relliky/Sunshine/product_documents/photos/sunshine/hardware_design.JPG

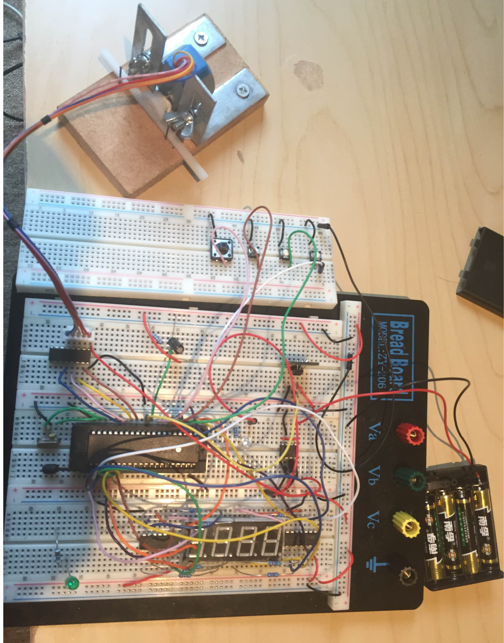
product_documents/photos/sunshine/hardware_design.JPG
