relliky/Sunshine/product_documents/photos/Physical_Design.JPG

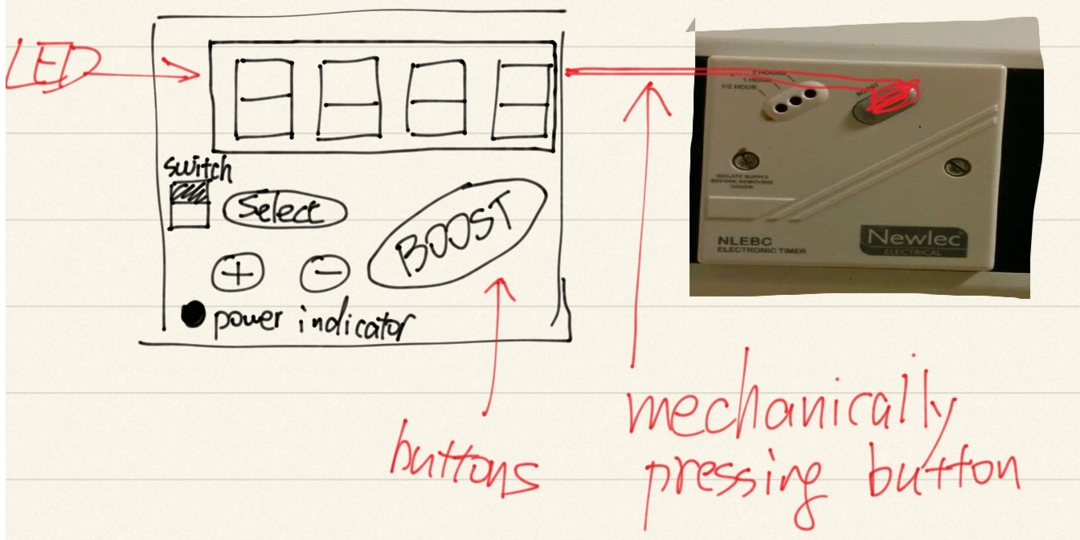
product_documents/photos/Physical_Design.JPG
