relliky/Sunshine/product_documents/Sunshine_Product_Requirement_Specification.docx

Product Requirement Specification

1. Customer Desired Requirement
i) Controlling room temperature in constant is ESSENTIAL
ii) Temperature can be set manually
iii) Low cost
iv) Low noise – Low frequency control
v) Battery can last long enough that customer can stand
2. Physical Requirment
i) Tightly attached to the timer pad
ii) Reasonable size
iii) Reasonable weight
iv) Users can see LED indicators originally on the timer pad
