relliky/Sunshine/engineering/design/hardware/hardware_system.docx

1. Button

OMRON ELECTRONIC COMPONENTS - B3F-1000 - SWITCH, SPNO, 0.05A, 24V, THT, 0.98N

http://onecall.farnell.com/omron-electronic-components/b3f-1000/switch-spno-0-05a-24v-tht-0-98n/dp/176432

Spec: see folder

2. Regulator

MAXIM INTEGRATED PRODUCTS - MAX603CPA+ - IC, V REG LDO ADJ/+5.0V, DIP8, 603

http://onecall.farnell.com/maxim-integrated-products/max603cpa/ic-v-reg-ldo-adj-5-0v-dip8-603/dp/1290858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

Spec: see folder

3. Darlington Transistor

STMICROELECTRONICS - ULN2003A - DARLINGTON ARRAY 7NPN, 2003, DIP16

http://onecall.farnell.com/stmicroelectronics/uln2003a/darlington-array-7npn-2003-dip16/dp/1094421

Spec: see folder

4. DS18B20 Thermometer

MAXIM INTEGRATED PRODUCTS - DS18B20+ - PROGRAMMABLE DIGITAL T'MOM, 12BIT

http://onecall.farnell.com/maxim-integrated-products/ds18b20/programmable-digital-t-mom-12bit/dp/SC10426

Spec: see folder

5. Jumper

MULTICOMP (FORMERLY FROM SPC) - SPC20479 - SHUNT JUMPER, 2POS, CODE STRIP LINE PLUG

http://onecall.farnell.com/multicomp-formerly-from-spc/spc20479/shunt-jumper-2pos-code-strip-line/dp/2396301

Spec: see folder

6. Crystal

TXC - 9B-11.0592MAAJ-B - XTAL, 11.0592MHZ, 18PF, HC-49S

http://onecall.farnell.com/txc/9b-11-0592maaj-b/xtal-11-0592mhz-18pf-hc-49s/dp/1842198

7. Battery Holder

PRO POWER - 23VB31B - BATTERY HOLDER, 3XAA SNAP

http://onecall.farnell.com/pro-power/23vb31b/battery-holder-3xaa-snap/dp/BT03710

Spec: see web
