relliky/Sunshine/misc/misc_photos/IMG_4469.JPG

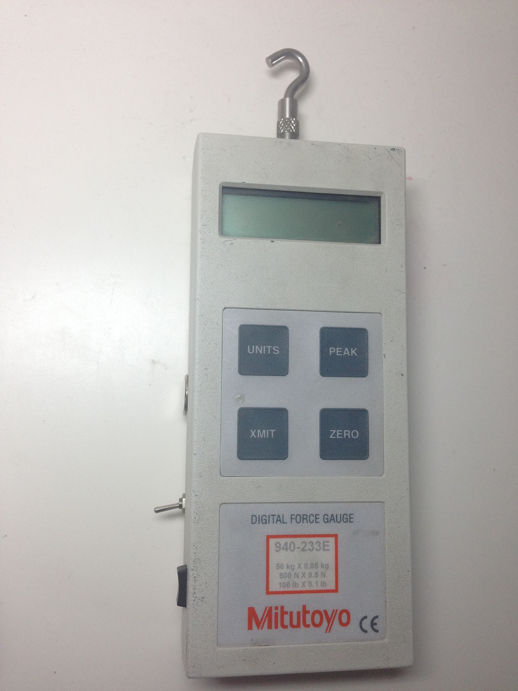
misc/misc_photos/IMG_4469.JPG
