relliky/Sunshine/misc/misc_photos/IMG_4470.JPG

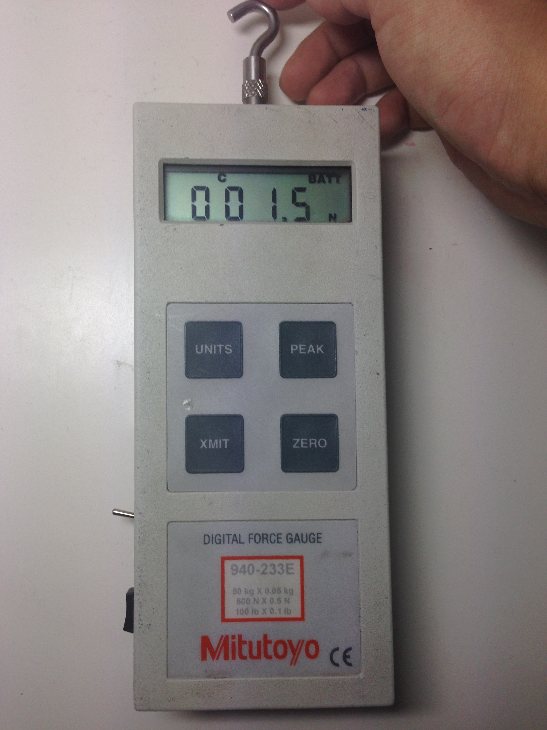
misc/misc_photos/IMG_4470.JPG
