relliky/Sunshine/misc/misc_photos/IMG_4477.JPG

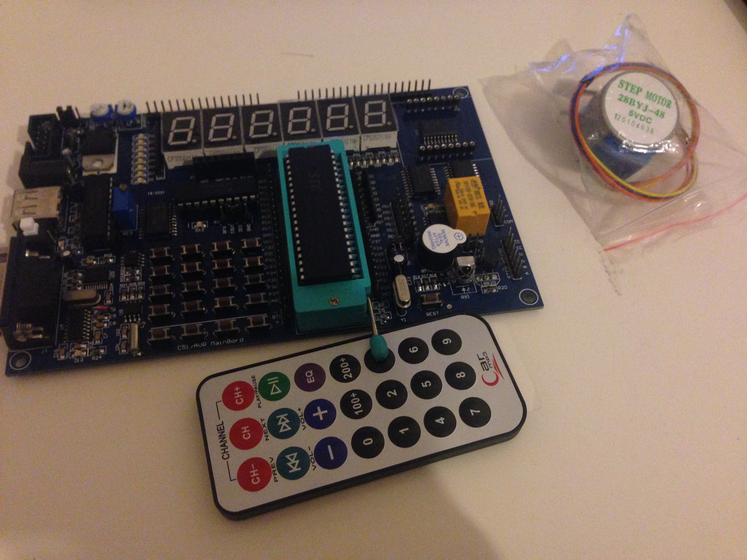
misc/misc_photos/IMG_4477.JPG
