relliky/Sunshine/misc/misc_photos/IMG_4478.JPG

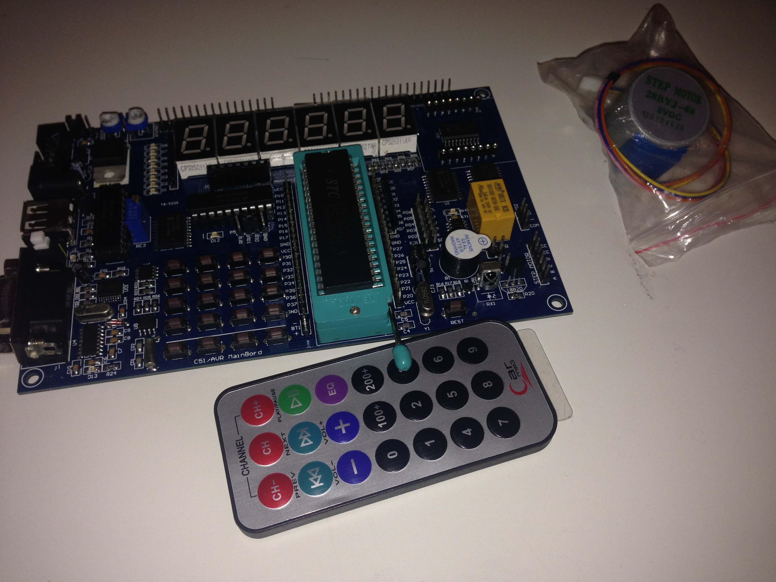
misc/misc_photos/IMG_4478.JPG
