relliky/Sunshine/misc/misc_photos/IMG_4536.JPG

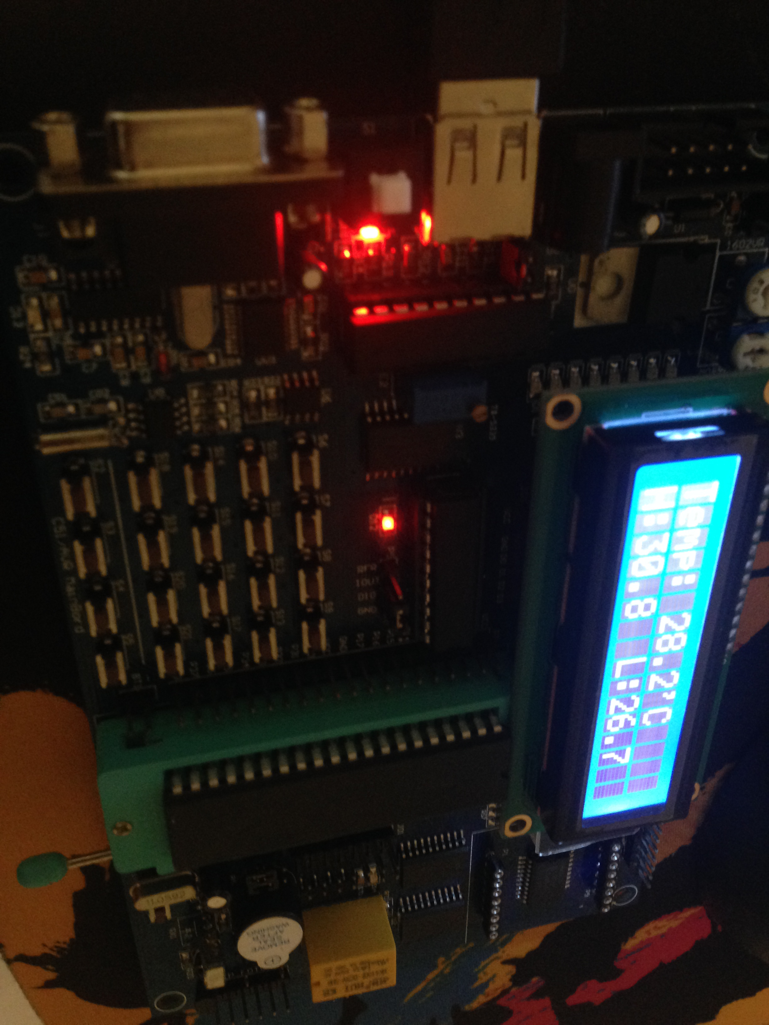
misc/misc_photos/IMG_4536.JPG
