relliky/Sunshine/misc/misc_photos/IMG_4537.JPG

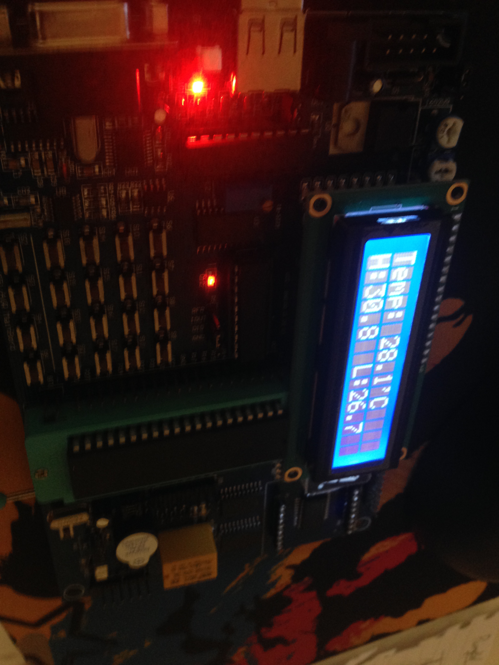
misc/misc_photos/IMG_4537.JPG
