relliky/Sunshine/misc/misc_photos/IMG_4538.JPG

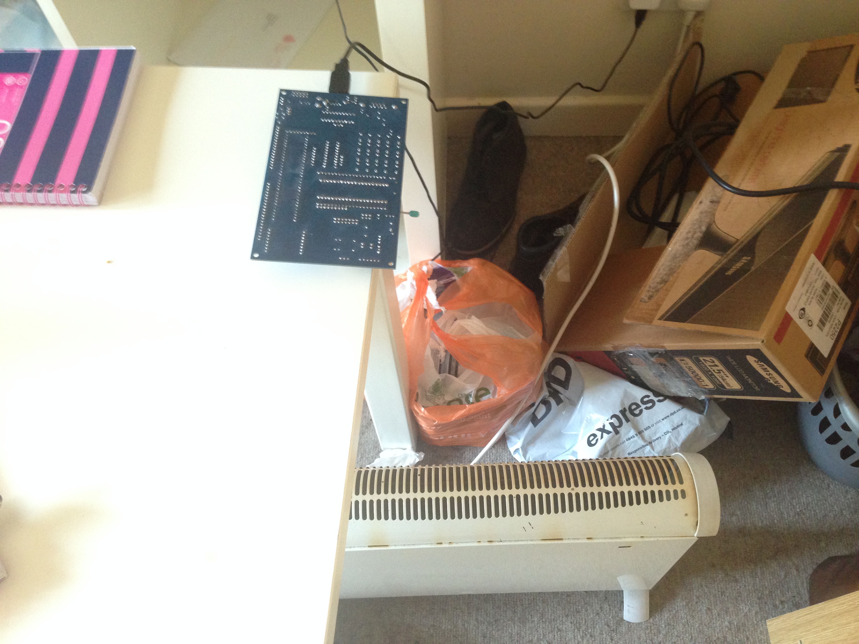
misc/misc_photos/IMG_4538.JPG
