relliky/Sunshine/misc/misc_photos/IMG_4539.JPG

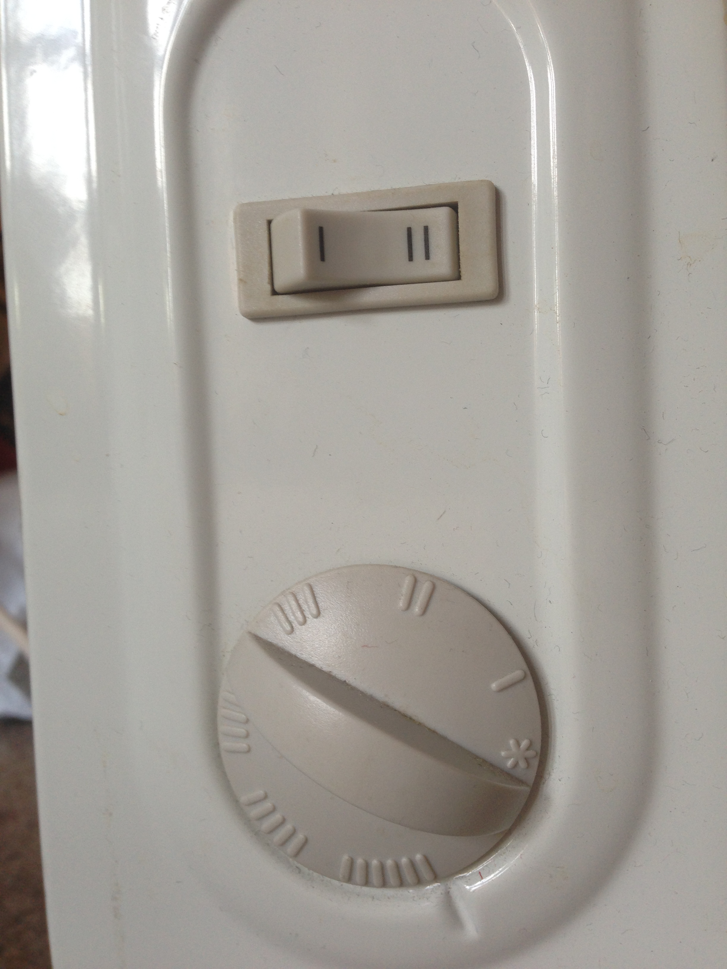
misc/misc_photos/IMG_4539.JPG
