relliky/Sunshine/misc/misc_photos/IMG_4540.JPG

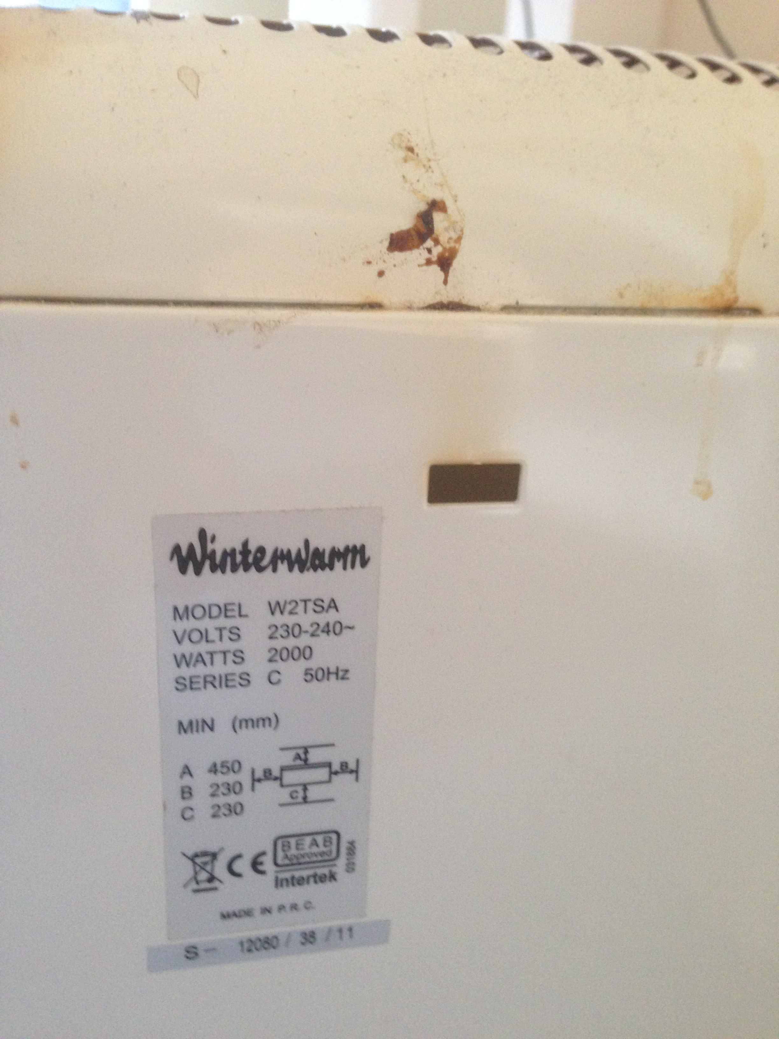
misc/misc_photos/IMG_4540.JPG
