relliky/Sunshine/misc/misc_photos/IMG_4542.JPG

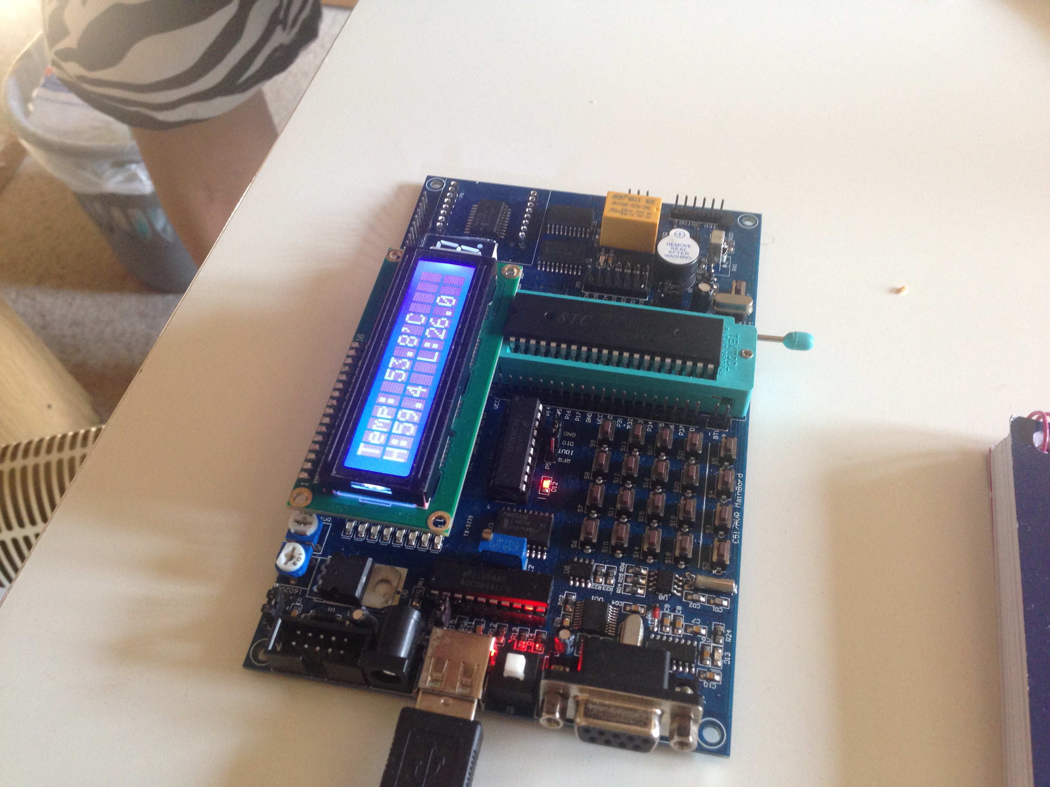
misc/misc_photos/IMG_4542.JPG
