relliky/Sunshine/product_documents/photos/exchange_works_timer.JPG

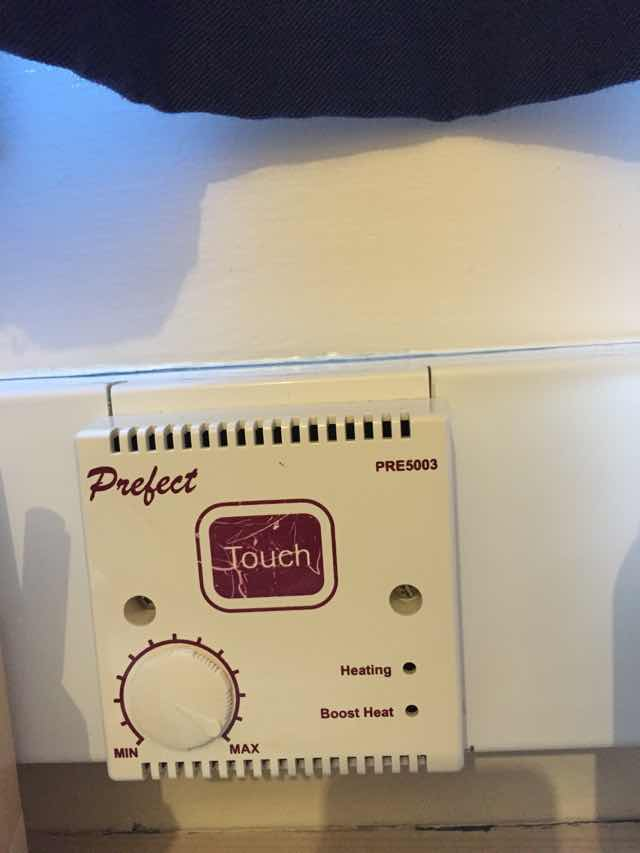
product_documents/photos/exchange_works_timer.JPG
