relliky/Sunshine/product_documents/photos/IMG_2048.JPG

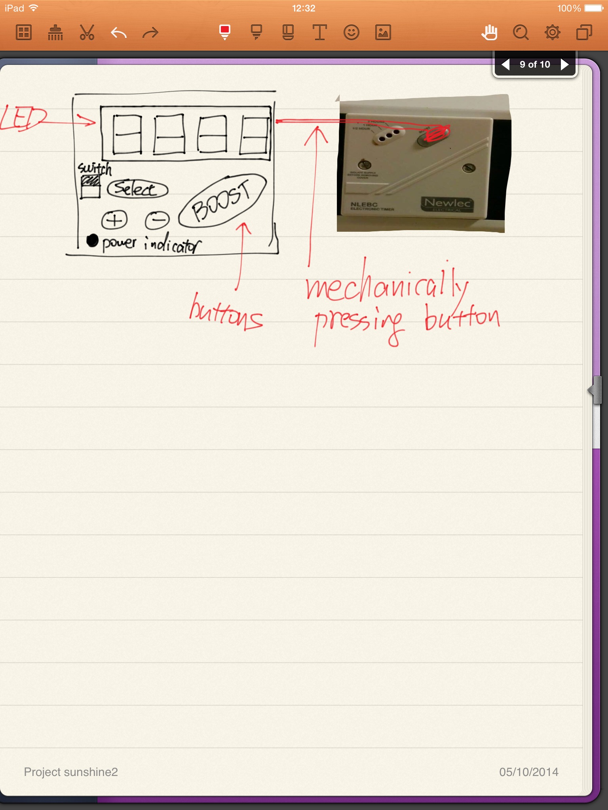
product_documents/photos/IMG_2048.JPG
