relliky/Sunshine/product_documents/photos/IMG_6342.JPG

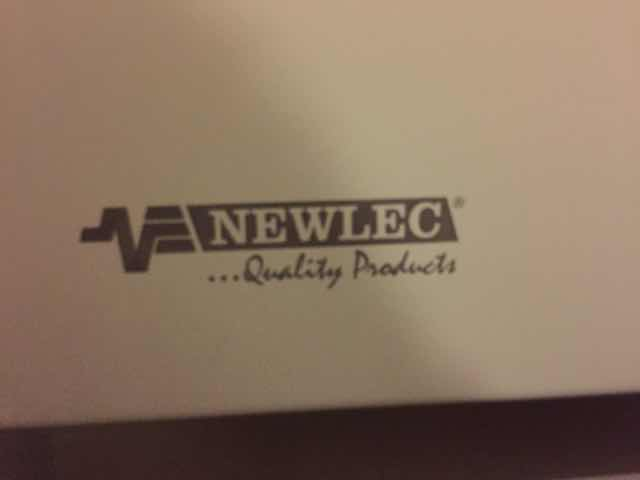
product_documents/photos/IMG_6342.JPG
