relliky/Sunshine/product_documents/photos/IMG_6343.JPG

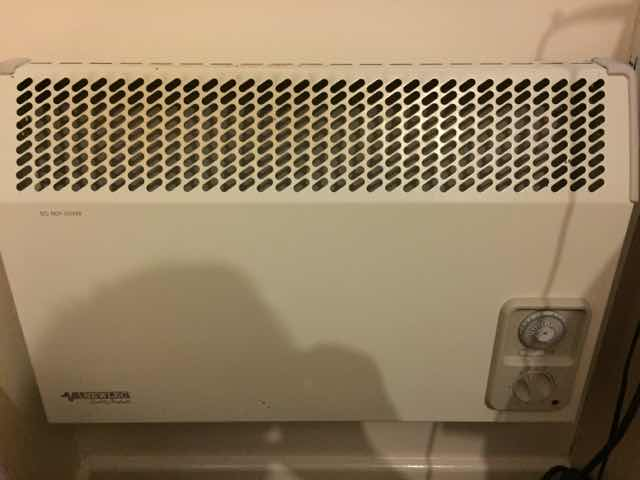
product_documents/photos/IMG_6343.JPG
