relliky/Sunshine/product_documents/photos/IMG_6344.JPG

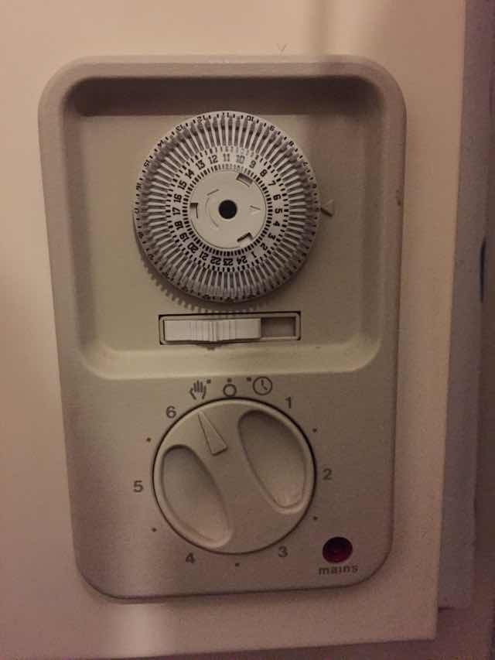
product_documents/photos/IMG_6344.JPG
