relliky/Sunshine/product_documents/photos/opal2_timer.JPG

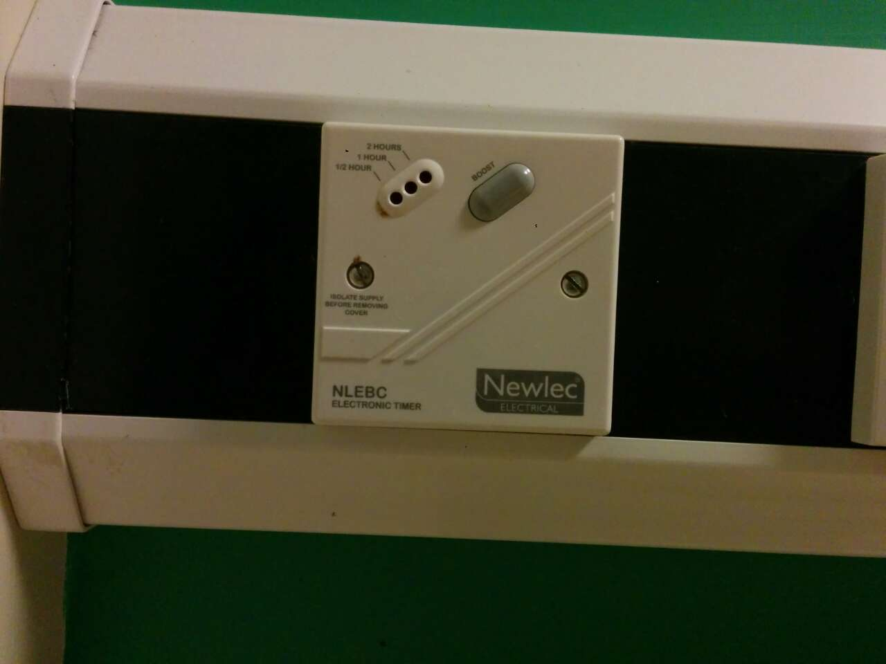
product_documents/photos/opal2_timer.JPG
