relliky/Sunshine/product_documents/photos/random.JPG

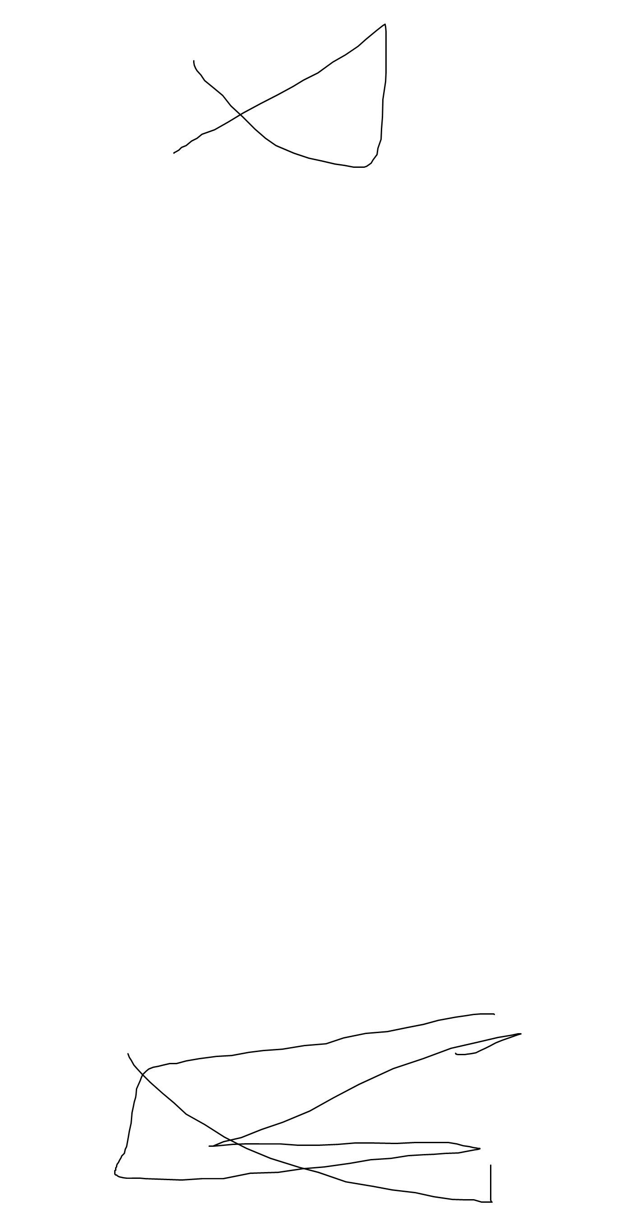
product_documents/photos/random.JPG
