relliky/Sunshine/product_documents/photos/sunshine/hardware_design_2.JPG

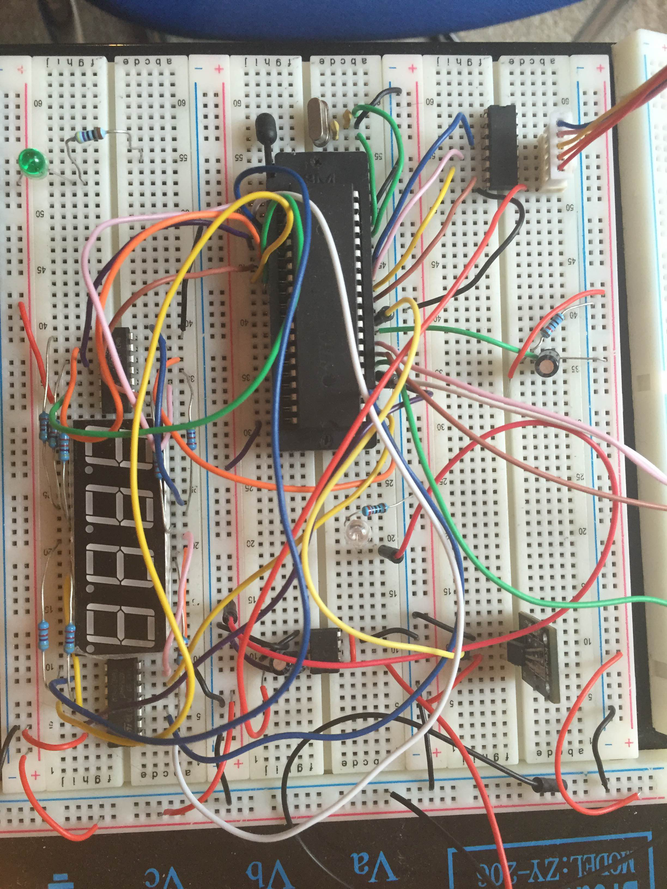
product_documents/photos/sunshine/hardware_design_2.JPG
