relliky/Sunshine/product_documents/photos/sunshine/IMG_6388.JPG

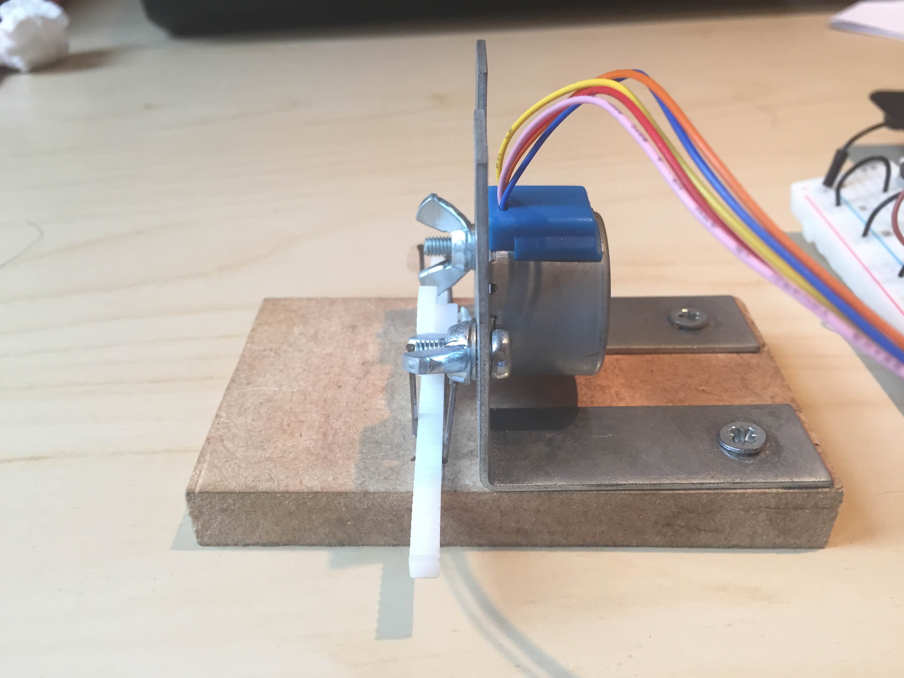
product_documents/photos/sunshine/IMG_6388.JPG
