relliky/Sunshine/product_documents/photos/sunshine/stepper_motor1.JPG

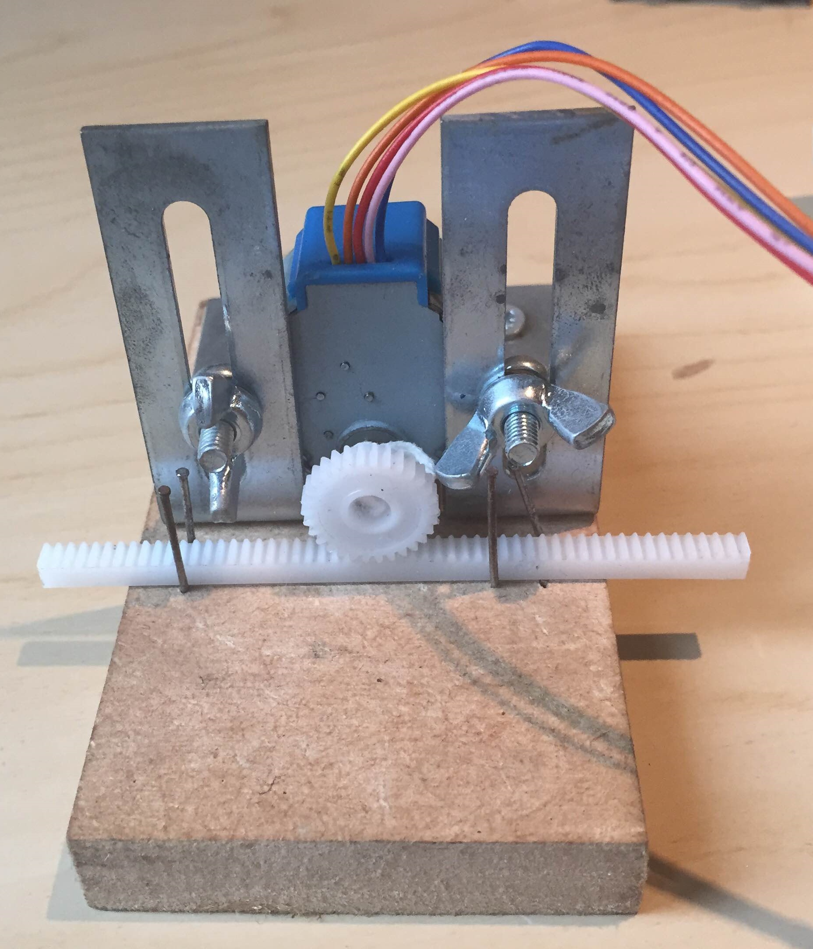
product_documents/photos/sunshine/stepper_motor1.JPG
