relliky/Sunshine/product_documents/photos/sunshine/stepper_motor2.JPG

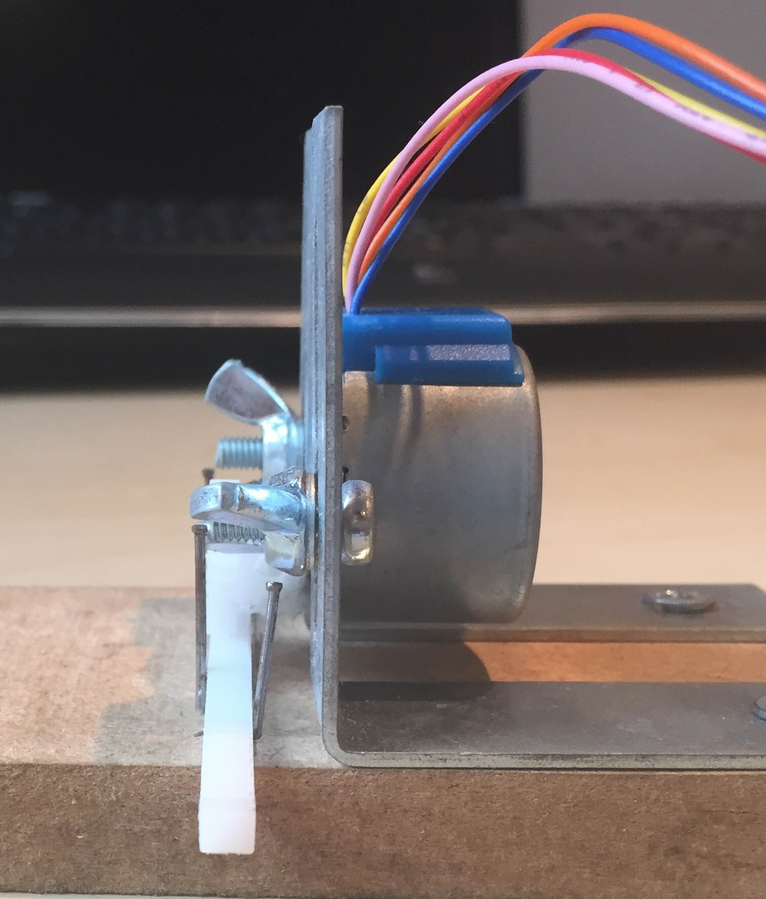
product_documents/photos/sunshine/stepper_motor2.JPG
