relliky/Sunshine/product_documents/photos/sunshine/System_Design1.JPG

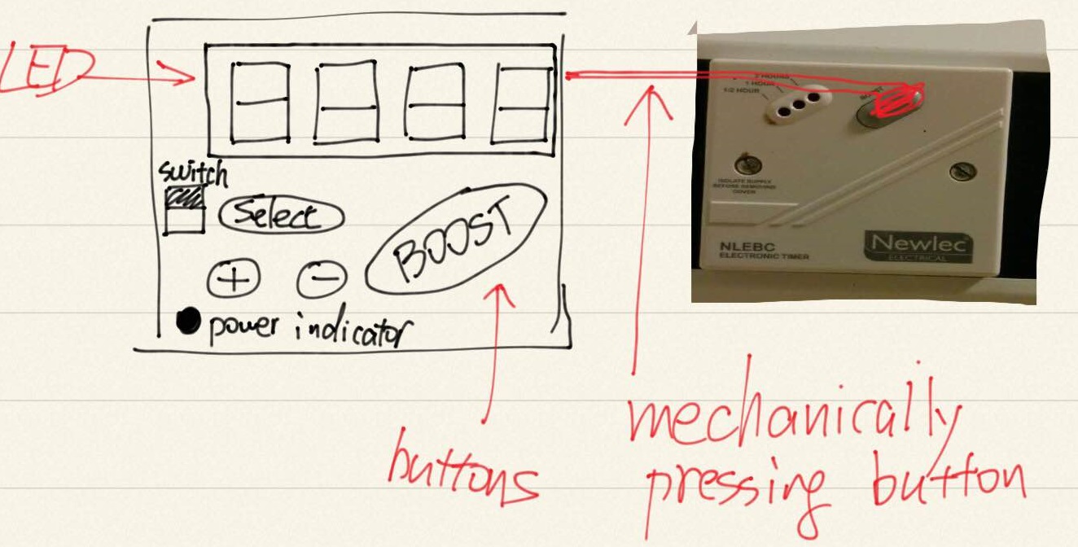
product_documents/photos/sunshine/System_Design1.JPG
