relliky/Sunshine/project_management/Project_cost.xlsx

Order | Date |  | Number | Price_without_tax | Price_with_tax | Total price | Order price | Links to item
1 | 2014-07-07 | spur_gears | 2 |  | 2.64 | 5.28 |  | RS POM 50 Teeth Spur Gear, 25mm Pitch Diam. , 12mm Hub Diam. , 5mm Bore Diam. (http://uk.rs-online.com/web/p/products/5217146/)
 |  | spur_gears | 1 |  | 1.76 | 1.76 |  | RS POM 30 Teeth Spur Gear, 15mm Pitch Diam. , 10mm Hub Diam. , 5mm Bore Diam. (http://uk.rs-online.com/web/p/products/5217067/)
 |  | delivery | 1 |  | 4.95 | 4.95 | 11.99
2 | 2014-07-07 | solenoid_PED | 1 | 8.99 | 5.64 | 5.64 |  | SW02519 (http://onecall.farnell.com/jsp/search/productdetail.jsp?sku=SW02519)
 |  | solenoid_MULTICOMP | 1 | 7.46 | 8.952 | 8.952 |  | 2008796 (http://onecall.farnell.com/jsp/search/productdetail.jsp?sku=2008796)
 |  | racks | 2 | 3.84 | 4.608 | 9.216 |  | 3470283 (http://onecall.farnell.com/jsp/search/productdetail.jsp?sku=3470283)
 |  | racks | 2 | 2.22 | 2.664 | 5.328 | 29.136 | 3470271 (http://onecall.farnell.com/jsp/search/productdetail.jsp?sku=3470271)
3 | 2014-07-07 | Stretcher Plates x10 pack | 1 |  | 1.25 | 1.25 |  | http://www.screwfix.com/p/stretcher-plates-38-x-28-x-25mm-zinc-plated-pack-of-10/12920
 |  | delivery | 1 |  | 5 | 5 | 6.25
4 | 2014-07-14 | Adjustable Bracket x10 pack | 1 | 4.7 | 5.64 | 5.64 |  | http://www.ironmongerydirect.co.uk/products/cabinet_furniture_and_hardware/furniture_brackets_and_fixings/13362/adjustable_bracket_bright_zinc_plated_/745046
 |  | Adjustable Bracket x10 pack | 1 | 3.95 | 4.74 | 4.74 |  | http://www.ironmongerydirect.co.uk/products/cabinet_furniture_and_hardware/furniture_brackets_and_fixings/556/corner_bracket_bright_zinc_plated/284323
 |  | delivery | 1 | 5.95 | 7.14 | 7.14 | 17.52
5 | 2014-07-14 | Switch | 20 | 0.278 | 0.3336 | 6.672 |  | 176432 (http://onecall.farnell.com/jsp/search/productdetail.jsp?sku=176432)
 |  | Regulator | 2 | 4.43 | 5.316 | 10.632 |  | 1290858 (http://onecall.farnell.com/jsp/search/productdetail.jsp?sku=1290858)
 |  | DARLINGTON ARRAY | 2 | 0.52 | 0.624 | 1.248 |  | 1094421 (http://onecall.farnell.com/jsp/search/productdetail.jsp?sku=1094421)
 |  | thermometer | 3 | 3.5 | 4.2 | 12.6 |  | SC10426 (http://onecall.farnell.com/jsp/search/productdetail.jsp?sku=SC10426)
 |  | jumper | 20 | 0.055 | 0.066 | 1.32 |  | 2396301 (http://onecall.farnell.com/jsp/search/productdetail.jsp?sku=2396301)
 |  | crystal 11.0592M | 4 | 0.33 | 0.396 | 1.584 |  | 1842198 (http://onecall.farnell.com/jsp/search/productdetail.jsp?sku=1842198)
 |  | battery holders | 4 | 0.69 | 0.828 | 3.312 | 37.368 | BT03710 (http://onecall.farnell.com/jsp/search/productdetail.jsp?sku=BT03710)
6 | 2014-09-11 | Latch | 10 | 0.39 | 0.468 | 4.68 |  | 380829 (http://onecall.farnell.com/jsp/search/productdetail.jsp?sku=380829)
 |  | MAX232 | 5 | 0.84 | 1.008 | 5.04 |  | 1470445 (http://onecall.farnell.com/jsp/search/productdetail.jsp?sku=1470445)
 |  | Darlington drivers | 10 | 2.1 | 2.52 | 25.2 |  | 1467829 (http://onecall.farnell.com/jsp/search/productdetail.jsp?sku=1467829)
 |  | Solenoid | 2 | 8.99 | 10.788 | 21.576 | 56.496 | SW02519 (http://onecall.farnell.com/jsp/search/productdetail.jsp?sku=SW02519)
