relliky/Sunshine/project_management/ordering_receipts/iromongeryDirect_1.png

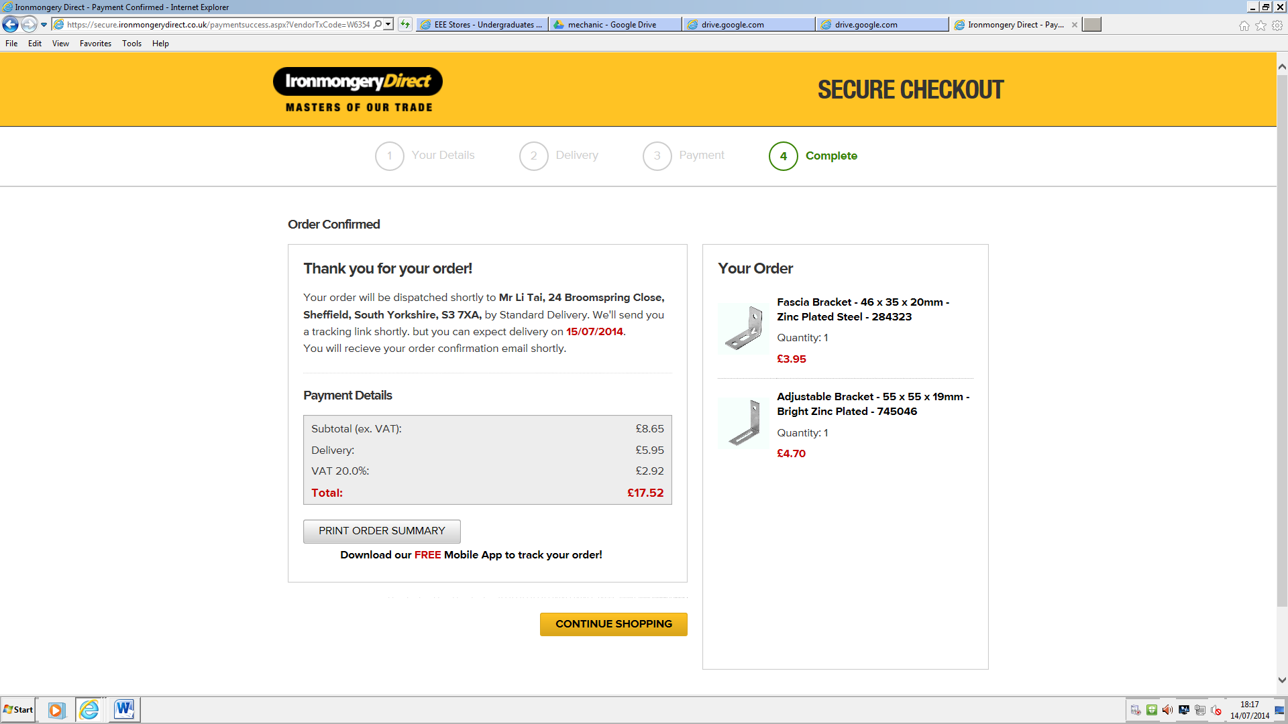
project_management/ordering_receipts/iromongeryDirect_1.png
