relliky/Sunshine/project_management/ordering_receipts/onecall_1.png

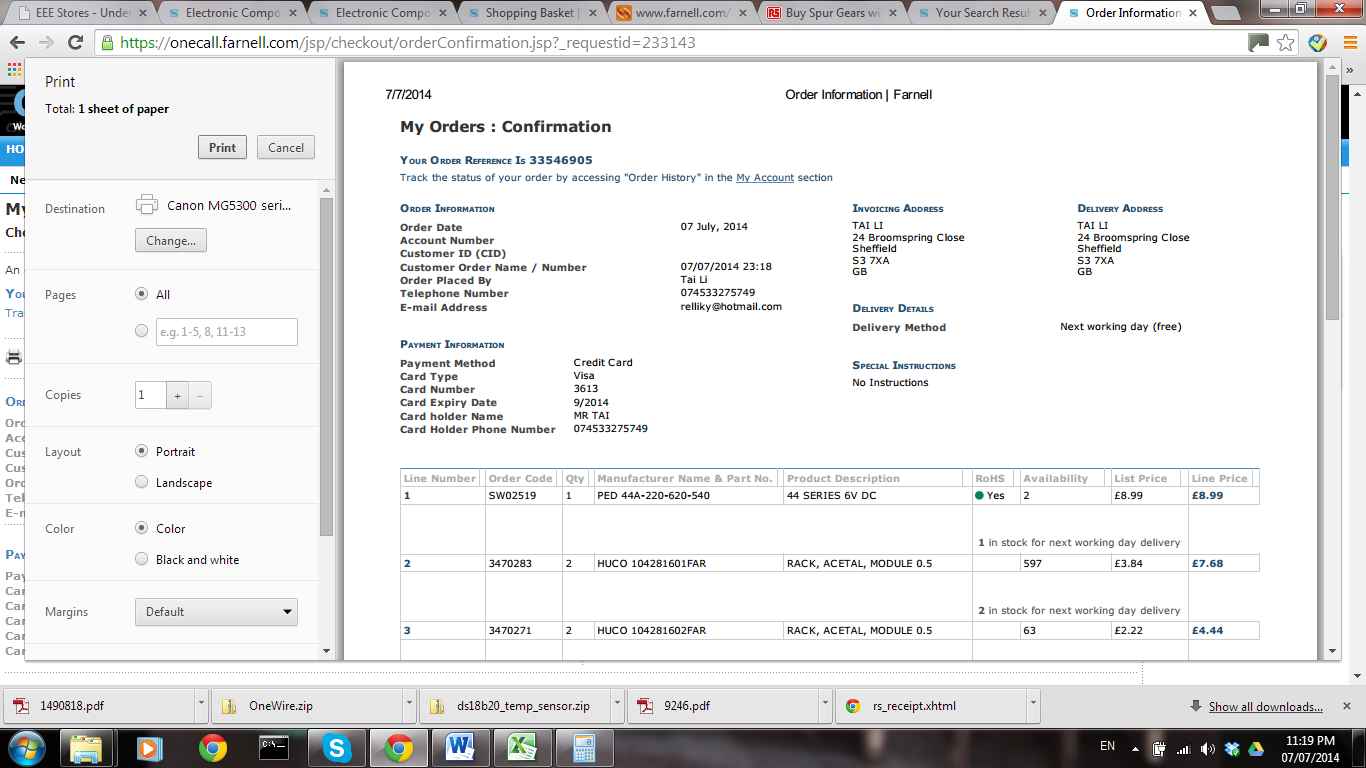
project_management/ordering_receipts/onecall_1.png
