relliky/Sunshine/project_management/ordering_receipts/onecall_2.png

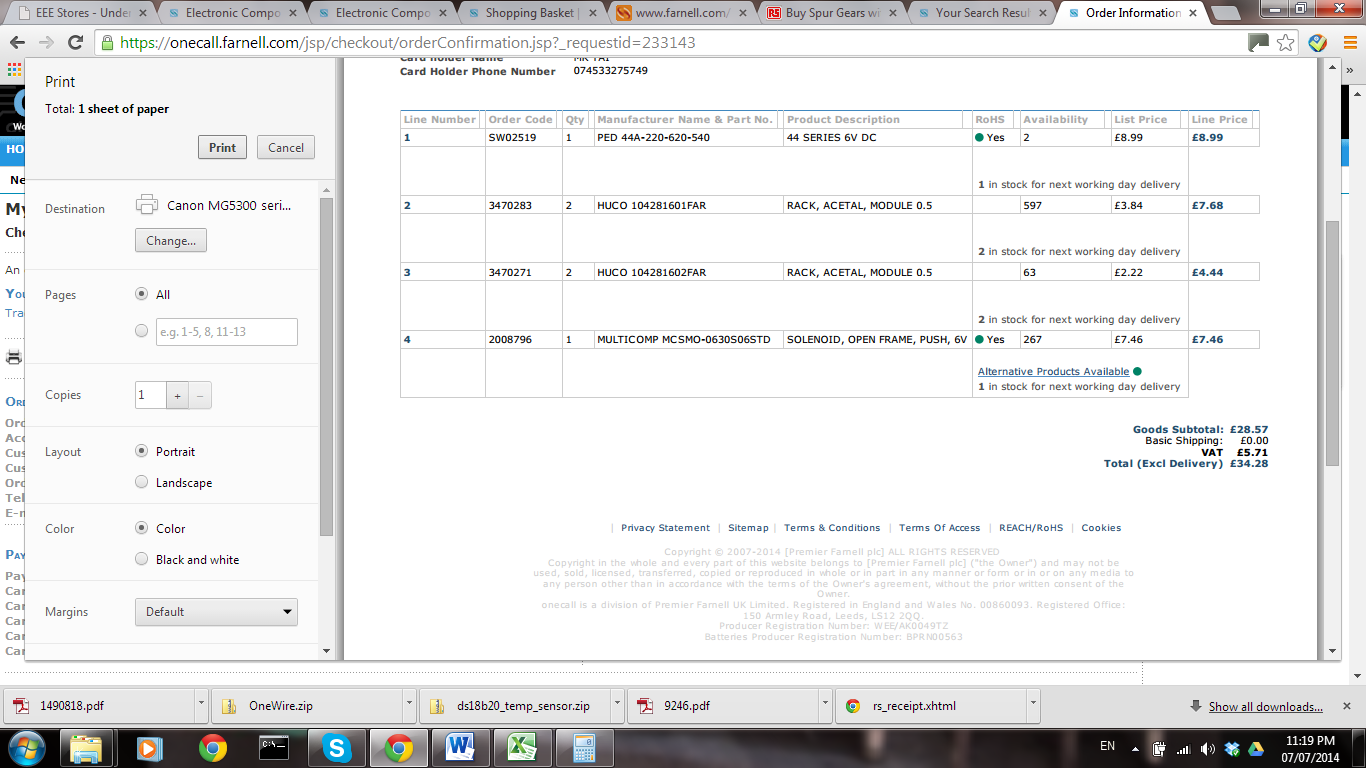
project_management/ordering_receipts/onecall_2.png
