relliky/Sunshine/project_management/ordering_receipts/onecall_2_1.png

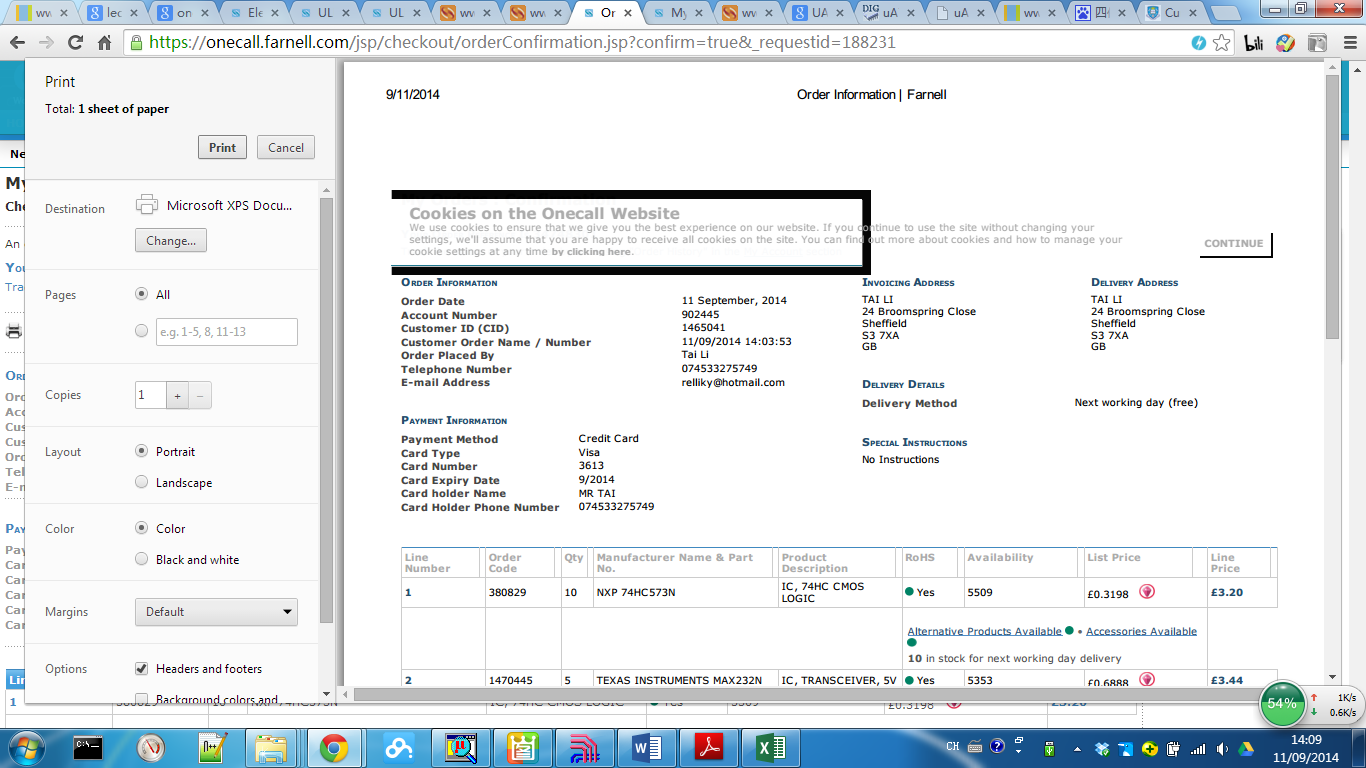
project_management/ordering_receipts/onecall_2_1.png
