relliky/Sunshine/project_management/ordering_receipts/onecall_2_2.png

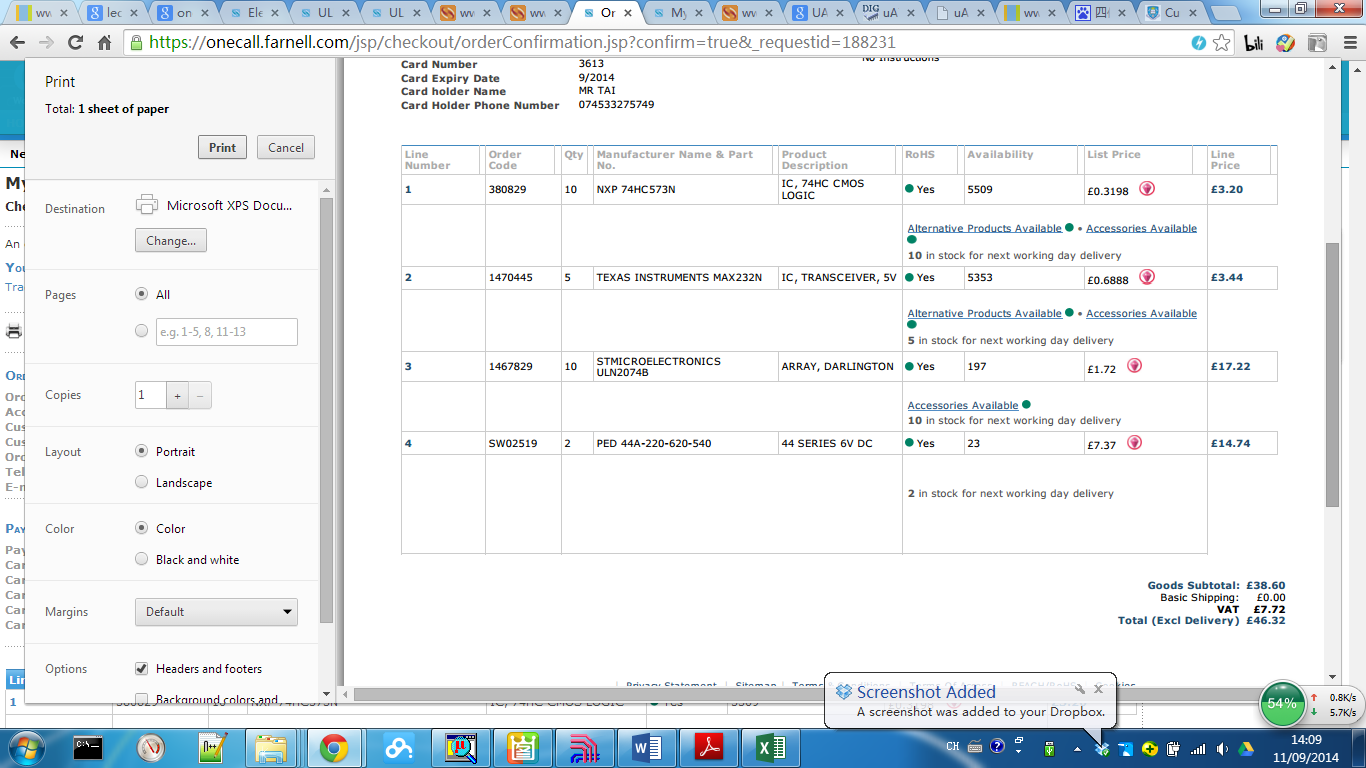
project_management/ordering_receipts/onecall_2_2.png
