relliky/Sunshine/project_management/ordering_receipts/onecall_2_3.png

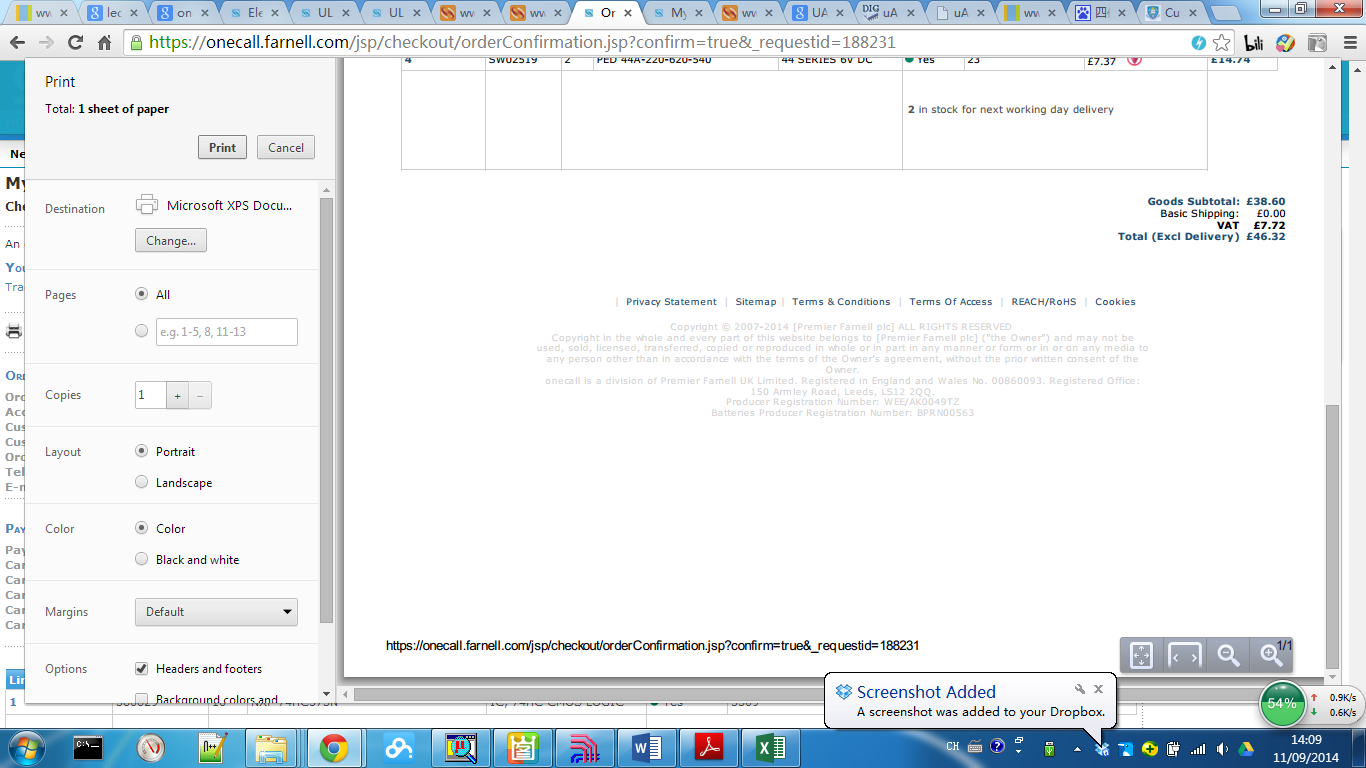
project_management/ordering_receipts/onecall_2_3.png
