relliky/Sunshine/project_management/ordering_receipts/rs_1.png

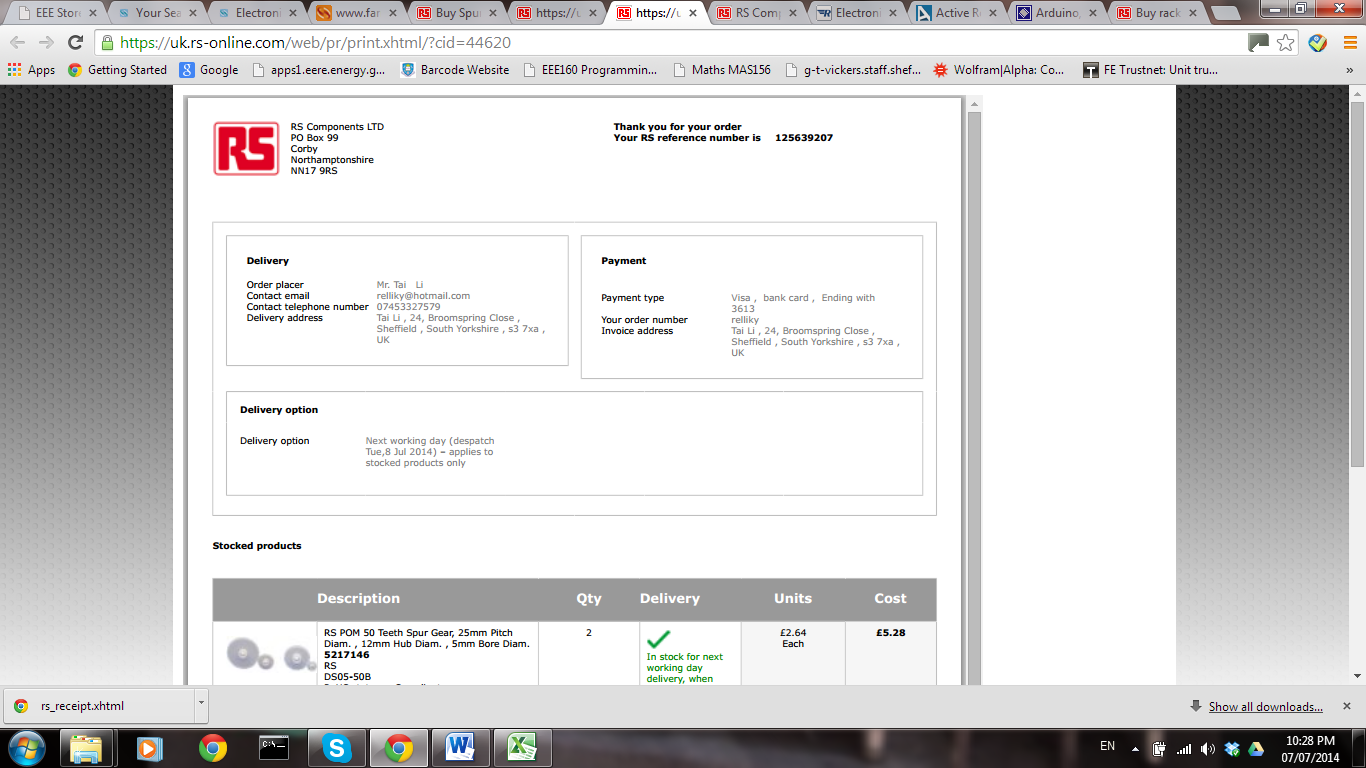
project_management/ordering_receipts/rs_1.png
