relliky/Sunshine/project_management/ordering_receipts/rs_2.png

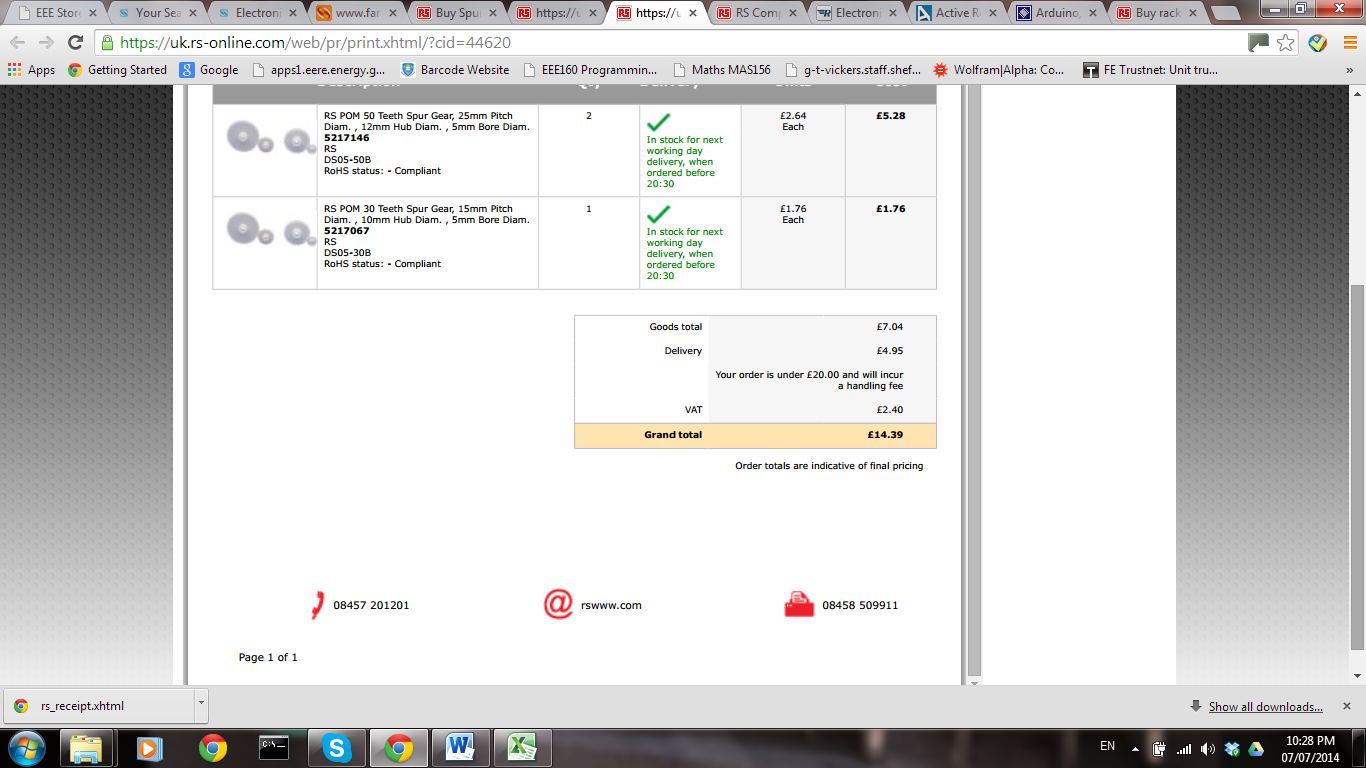
project_management/ordering_receipts/rs_2.png
