relliky/Sunshine/(list of files, cad)

Other CAD files:
engineering/verification/software/stepper/main.OBJ
engineering/design/software/Sunshine_uVersion2/main.OBJ
engineering/verification/software/DS18b20_uVersion5/main.OBJ
engineering/design/software/Sunshine/main.OBJ
engineering/verification/software/stepper_uVersion2/main.OBJ
engineering/design/software/Motor_timer_interrupt/STARTUP.obj
engineering/design/software/Motor_while_delay/motor_while_delay.OBJ
engineering/design/software/p0/p0.OBJ
engineering/design/software/pressing_buttons_to_set_LED/pressing_buttons_to_set_LED.OBJ
engineering/design/software/solenoid/solenoid.OBJ
engineering/design/software/Sunshine/timer_interrupt.OBJ
engineering/design/software/Sunshine_uVersion2/STARTUP.obj
engineering/design/software/uVersion5_project_pressing_buttons_to_set_LED/STARTUP.OBJ
engineering/verification/software/dev_board_stepper/STARTUP.obj
engineering/verification/software/digit/digit.OBJ
engineering/verification/software/digit_LED_display/STARTUP.obj
engineering/verification/software/DS18b20_uVersion5/timer_interrupt.OBJ
engineering/verification/software/keypad/STARTUP.obj
engineering/verification/software/Plus_minus_LED_number/plus_minus_LED_number.OBJ
engineering/verification/software/stepper_uVersion2/STARTUP.obj
engineering/verification/software/test_uVersion5/18b20.OBJ
engineering/design/software/Motor_timer_interrupt/motor_timer_interrupt.OBJ
engineering/design/software/Motor_while_delay/STARTUP.obj
engineering/design/software/p0/STARTUP.obj
engineering/design/software/pressing_buttons_to_set_LED/STARTUP.obj
engineering/design/software/solenoid/STARTUP.obj
engineering/design/software/Sunshine/led_display_high_level_driver.OBJ
engineering/design/software/Sunshine_uVersion2/stepper_high_level_driver.OBJ
engineering/design/software/uVersion5_project_pressing_buttons_to_set_LED/pressing_buttons_to_set_LED.OBJ
engineering/verification/software/dev_board_stepper/dev_board_stepper.OBJ
engineering/verification/software/digit/STARTUP.obj
engineering/verification/software/digit_LED_display/digit_LED_display.OBJ
engineering/verification/software/DS18b20_uVersion5/led_display_high_level_driver.OBJ
engineering/verification/software/keypad/keypad.OBJ
engineering/verification/software/Plus_minus_LED_number/STARTUP.obj
engineering/verification/software/stepper/stepper_high_level_driver.OBJ
engineering/verification/software/stepper_uVersion2/timer_interrupt.OBJ
engineering/verification/software/test_uVersion5/test.OBJ
engineering/design/software/Sunshine/power_manager.OBJ
engineering/verification/software/DS18b20_uVersion5/stepper_high_level_driver.OBJ
engineering/verification/software/stepper/timer_interrupt.OBJ
engineering/verification/software/stepper_uVersion2/led_display_high_level_driver.OBJ
engineering/verification/software/test_uVersion5/STARTUP.OBJ
engineering/design/software/Sunshine/STARTUP.OBJ
engineering/design/software/Sunshine_uVersion2/timer_interrupt.OBJ
engineering/verification/software/stepper/STARTUP.OBJ
engineering/verification/software/stepper_uVersion2/stepper_high_level_driver.OBJ
engineering/design/software/Sunshine_uVersion2/led_display_high_level_driver.OBJ
engineering/verification/software/DS18b20_uVersion5/STARTUP.OBJ
engineering/verification/software/stepper/led_display_high_level_driver.OBJ
engineering/design/software/Sunshine/stepper_high_level_driver.OBJ
engineering/verification/software/DS18b20_uVersion2/STARTUP.obj
engineering/verification/software/DS18b20_uVersion2/led_display_high_level_driver.OBJ
engineering/verification/software/DS18b20_uVersion2/main.OBJ
engineering/verification/software/DS18b20_uVersion2/stepper_high_level_driver.OBJ
engineering/verification/software/DS18b20_uVersion2/timer_interrupt.OBJ
engineering/verification/software/test_uVersion2/STARTUP.obj
engineering/verification/software/test_uVersion2/test.OBJ
