relliky/Sunshine/engineering/design/mechanic/step_motor/14、四相五线减速步进电机/四相五线制减速电机接线图.bmp

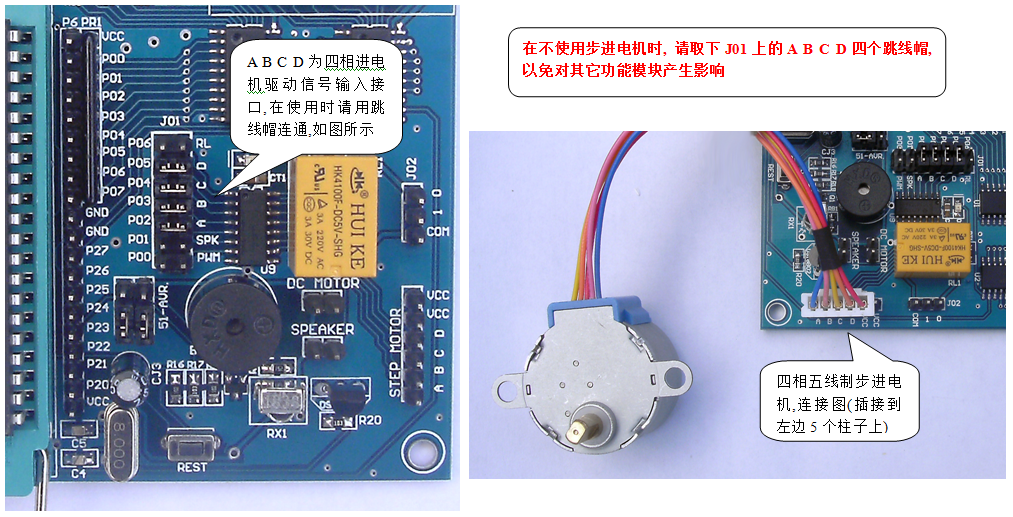
engineering/design/mechanic/step_motor/14、四相五线减速步进电机/四相五线制减速电机接线图.bmp
