relliky/Sunshine/project_management/ordering_receipts/Screw_fix_1.png

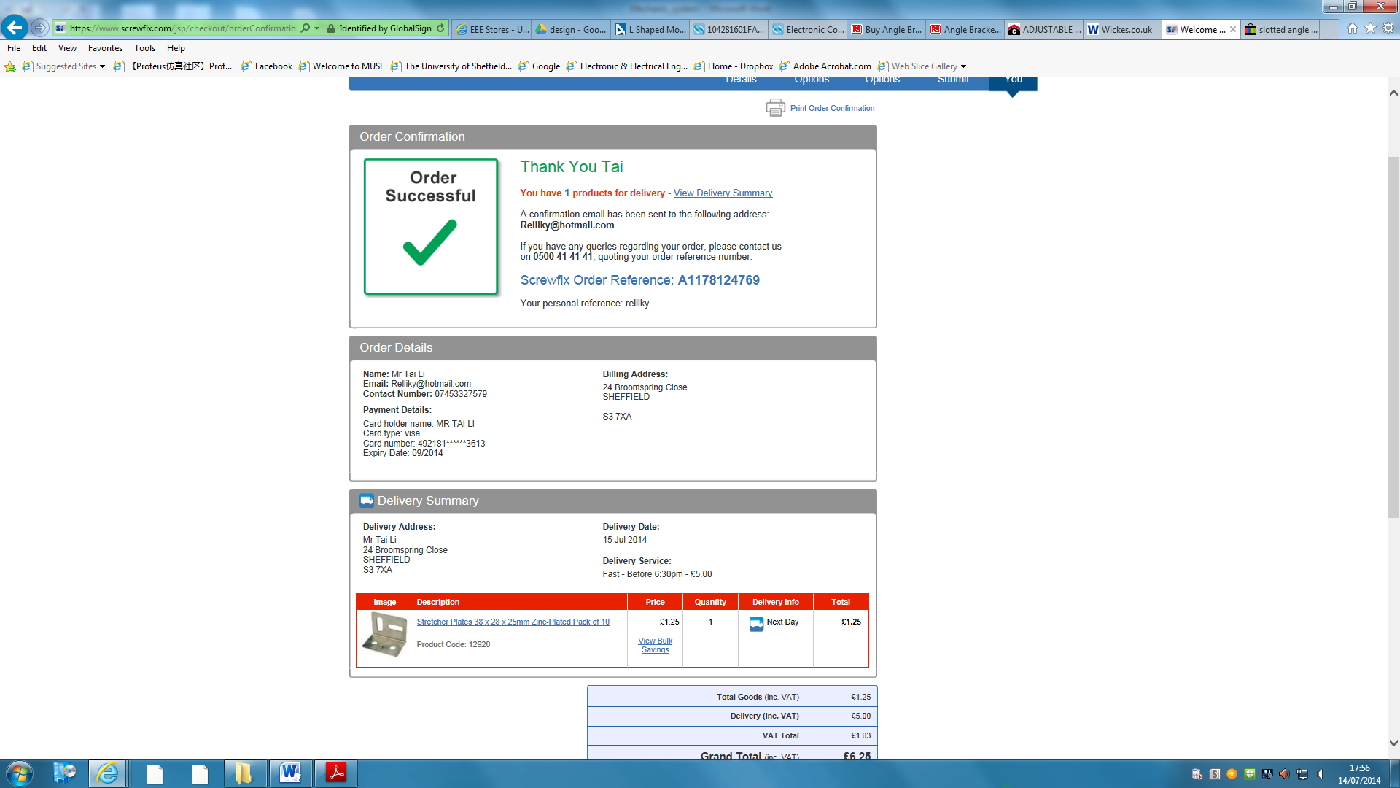
project_management/ordering_receipts/Screw_fix_1.png
