relliky/Sunshine/engineering/design/mechanic/step_motor/Angle_brackets/unused/L_bracket_1.pdf

n3

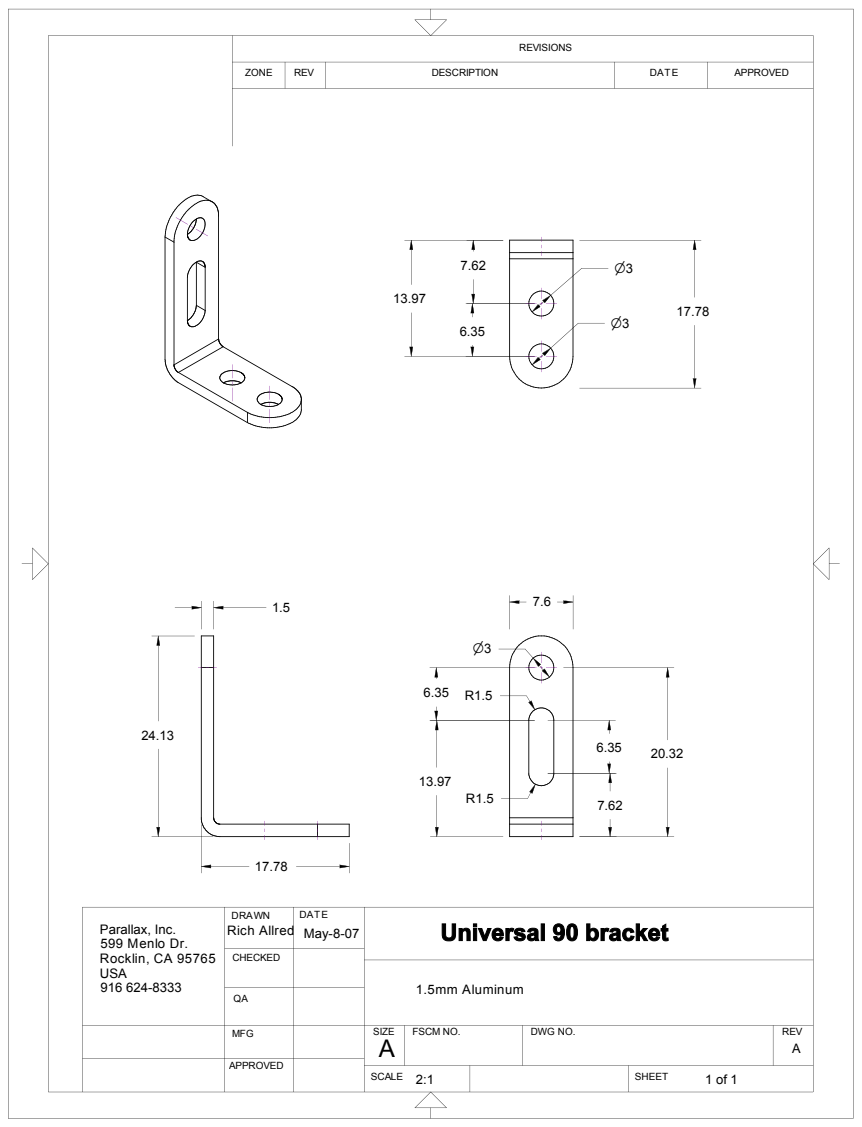
[picture p38: page 1]
REVISIONS; ZONE; REV; DESCRIPTION; DATE; APPROVED; DRAWN; CHECKED; MFG; SIZE A; FSCM NO.; DWG NO.; SCALE; SHEET; Parallax, Inc. 599 Menlo Dr. Rocklin, CA 95765 USA 916 624-8333; Rich Allred; May-8-07; Universal 90 bracket; 1.5mm Aluminum
