relliky/Sunshine/engineering/design/mechanic/step_motor/Angle_brackets/unused/angle_bracket_1.pdf

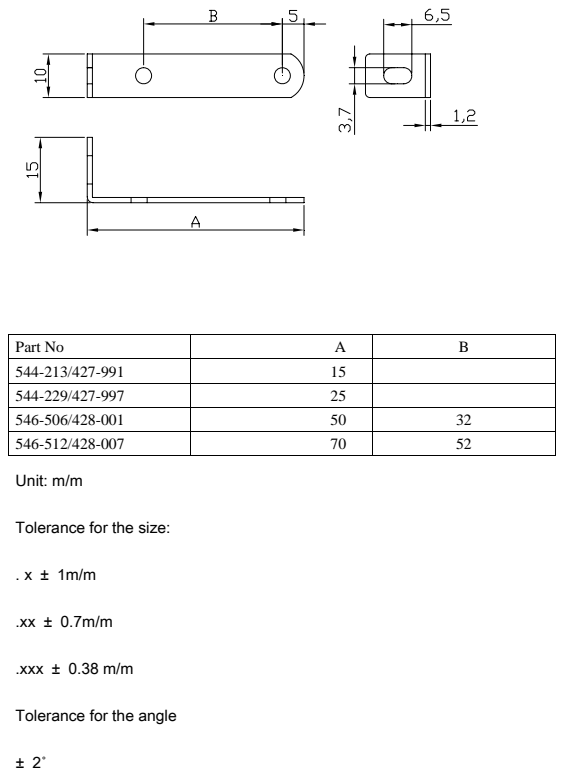
[picture p39: page 1]
Unit: m/m; .xxx ± 0.38 m/m

Part No | A | B
544-213/427-991 | 15
544-229/427-997 | 25
546-506/428-001 | 50 | 32
546-512/428-007 | 70 | 52

Tolerance for the size:

Tolerance for the angle
